Mathurinn/RoboRumble-Elimination-Submission/Folder C - Documentation/FQA_Proof/15 August.png

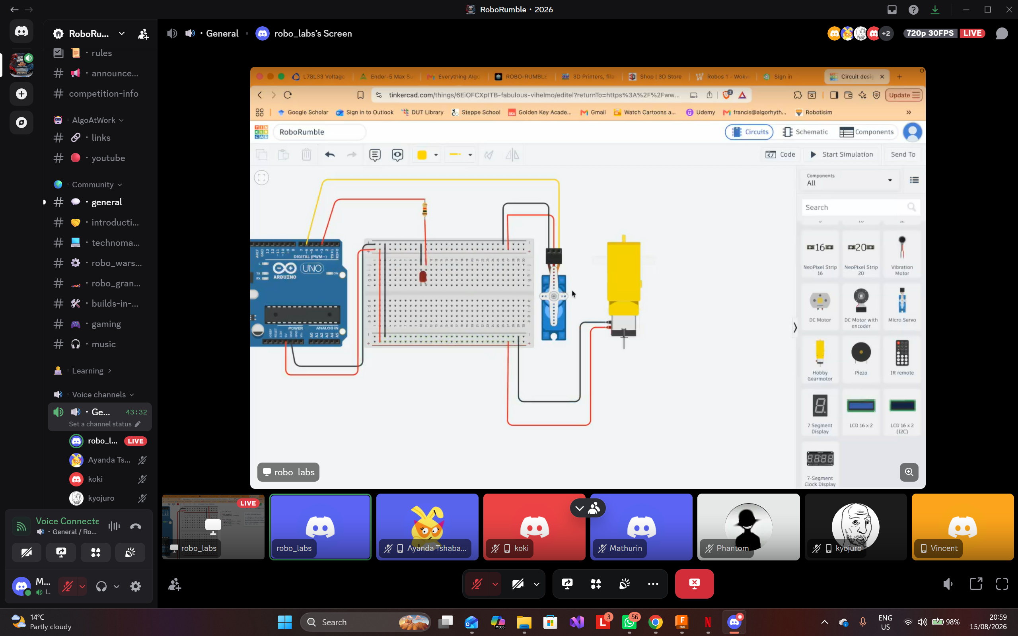
Folder C - Documentation/FQA_Proof/15 August.png
