Mathurinn/RoboRumble-Elimination-Submission/Folder A - Source Code/APEX_ONE_Flowchart.jpeg

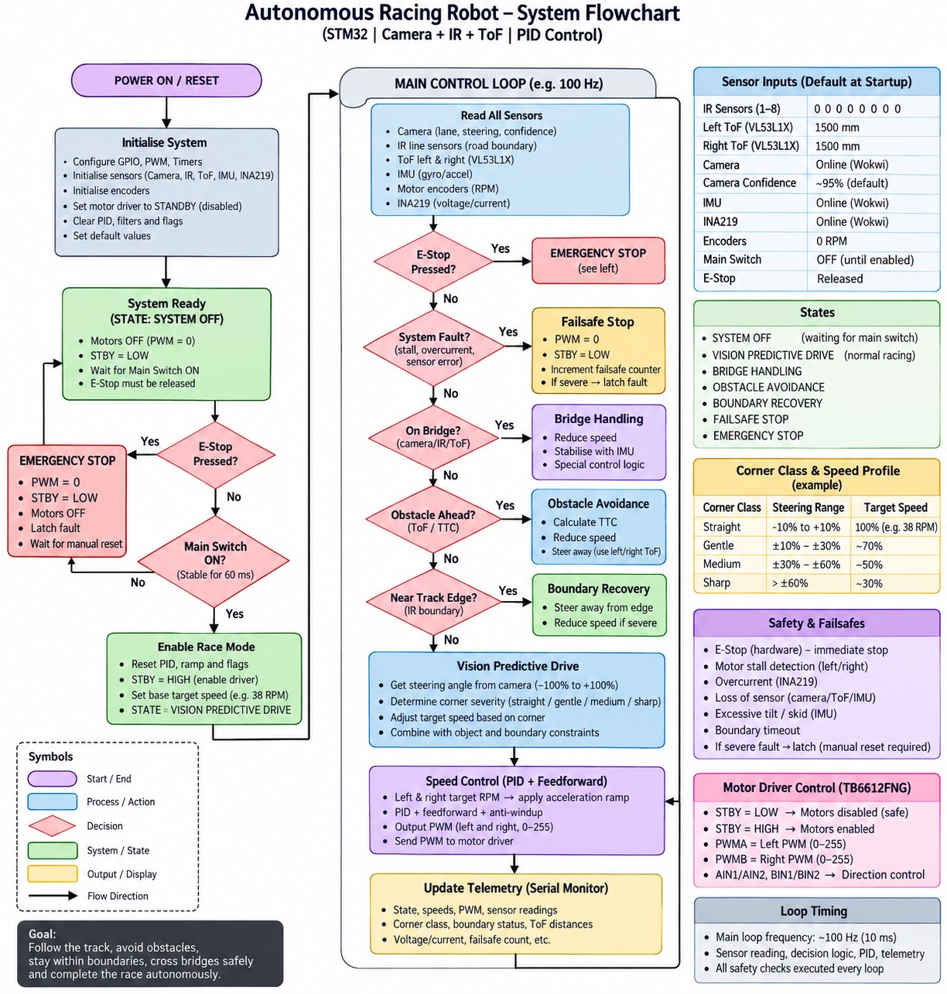
Folder A - Source Code/APEX_ONE_Flowchart.jpeg
