Mathurinn/RoboRumble-Elimination-Submission/Folder B - Designs/Mechanical_Design/APEX-ONE _ Mechanical Design.pdf

APEX-ONE / ROBO GRAND PRIX | MECHANICAL DESIGN

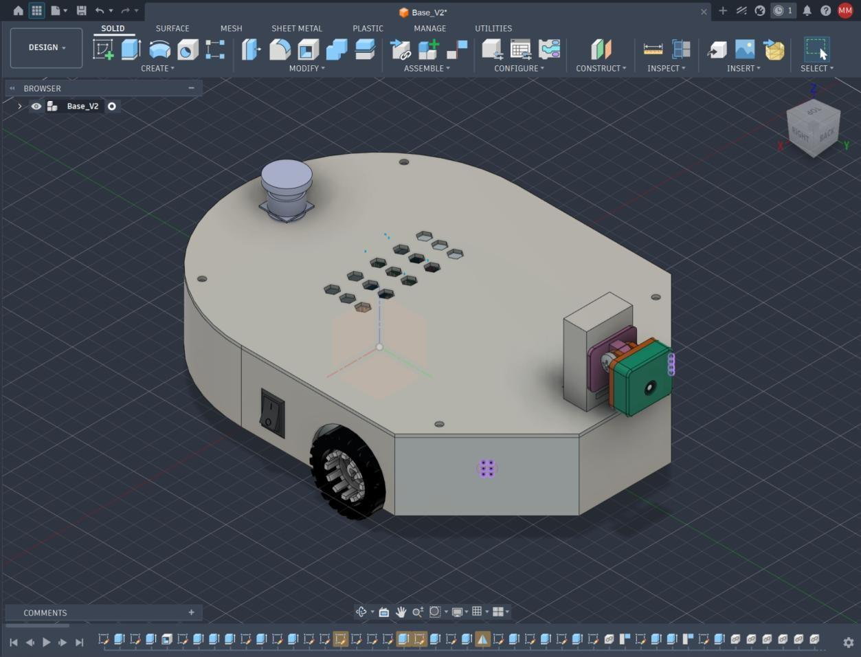
[picture p3: figure]

Mechanical Design | 1

MECHANICAL DESIGN

# Mechanical Design

- Raw CAD Assembly Files: The original 3D CAD file (APEX1.zip), compressed, is included in the repository's Mechanical Design folder for complete transparency regarding our mechanical architecture, dimensional tolerances, and 3D printing feasibility.

### Chassis Architecture & 3D Printing

The vehicle uses a custom-designed, two-piece chassis (base tub and top lid) which is fabricated using 3D printing. The shell is printed using a tri-hexagonal infill pattern which provides a better strength-to-weight density compared to standard grid infills. This helps balance structural integrity and economic feasibility. The chassis density is reduced to 15% to keep the chassis economically viable while maintaining a low chance of chipping. Localized areas supporting the hardware components are printed at a density of 20-25% to ensure that the threads and pillars are able to withstand mechanical stress and maintain a stable centre of gravity.

### Drive System and Kinematics

The robot makes use of a differential drive system that uses two GA12-N20 DC gear motors. These motors are fastened to the chassis using dedicated gear mounts and screws with locking nuts. Traction is provided by 43mm diameter wheels that fit directly onto the D-shafts of the gear motors. A rear-mounted castor ball wheel is secured directly through the underside of the chassis with locking nuts. This helps to establish a stable, 3-point turning radius that helps ground the weight of the chassis.

### Component Fastening and Electronic Integration

The internal electronics of the robot are designed for modularity and vibration resistance. The primary modules and microcontrollers, such as the STM32 Blue Pill, LM2596 buck converter, and motor driver, are not permanently soldered into the perfboard. They are placed into female header pins which are soldered onto the perfboard. The perfboard is screwed securely into structural pillars that are integrated into the chassis tub. The secondary processor, the Raspberry Pi, is screwed into four pillars on the underside of the lid to isolate it from motor vibration and to create more space inside the tub of the chassis. The Raspberry Pi Camera module is placed in an adjustable mount that is fused with the top lid of the chassis.

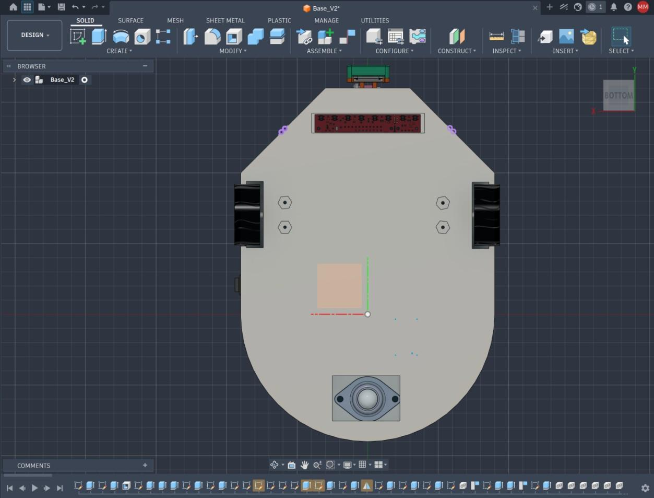
[picture p4: figure]

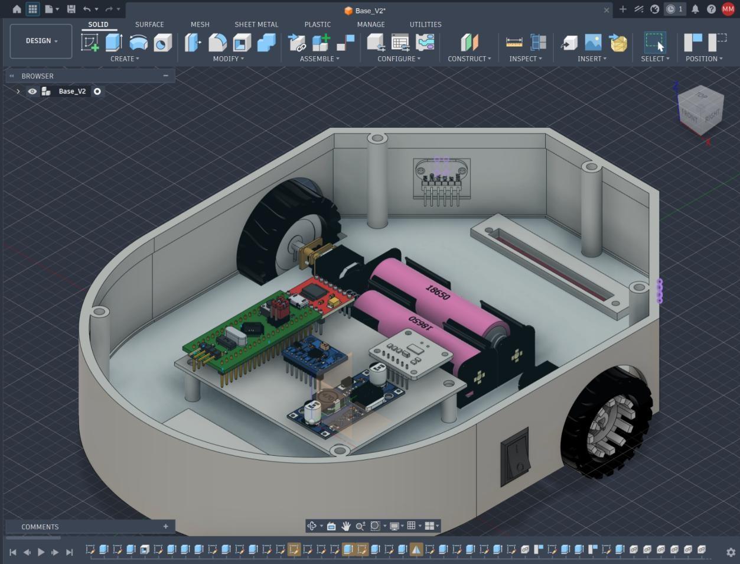
[picture p5: figure]

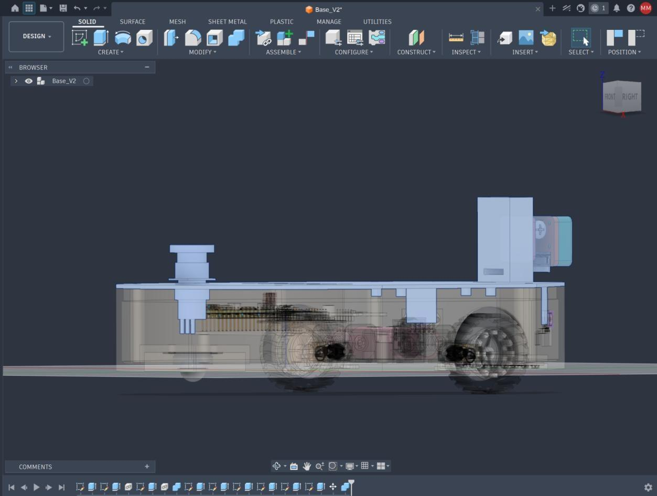
[picture p6: figure]

### Safety Mechanisms and Sensor Placement

The physical chassis incorporates dedicated housing for power cutoff systems in accordance with the competition's safety constraints. A primary rocker switch is fitted through a measured cutout in the side wall of the chassis, while the mandatory E-Stop (Emergency Stop) is mounted on the top of the lid for easier, immediate external access. For autonomous navigation, two ToF sensors are fitted into the front of the chassis at outward 45-degree angles to assist with cornering predictions. The top lid acts as a back support brace for these sensors, ensuring that they remain perfectly aligned in the case of high-speed collisions. The QTR-8RC is placed under the vehicle at a height that is optimal for operation and is bolted onto the inside of the chassis.

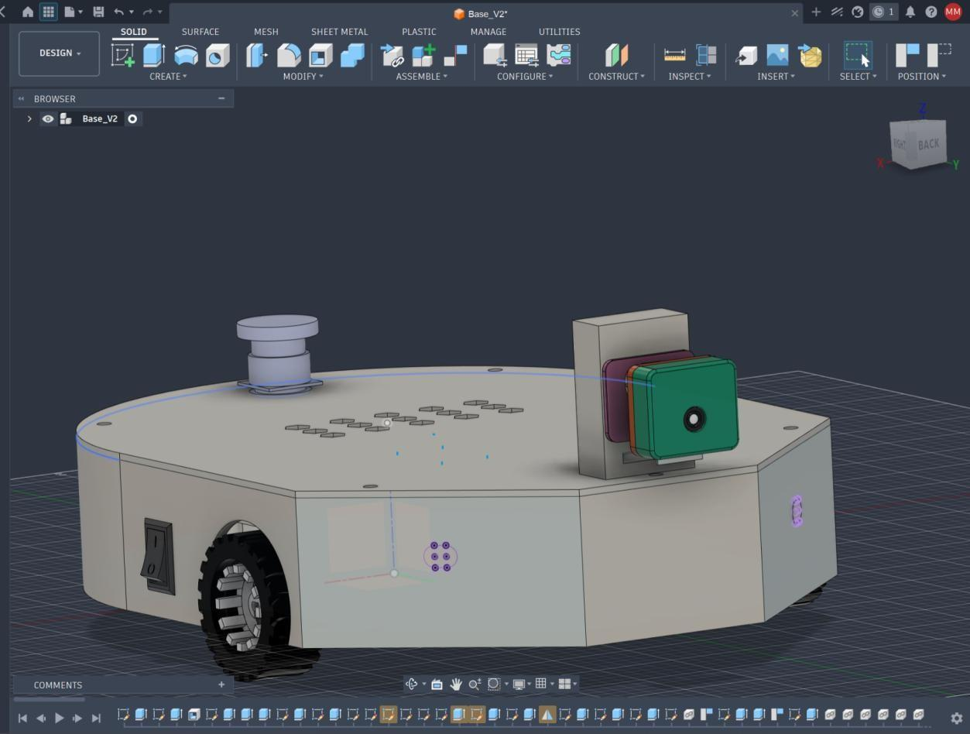
[picture p7: figure]

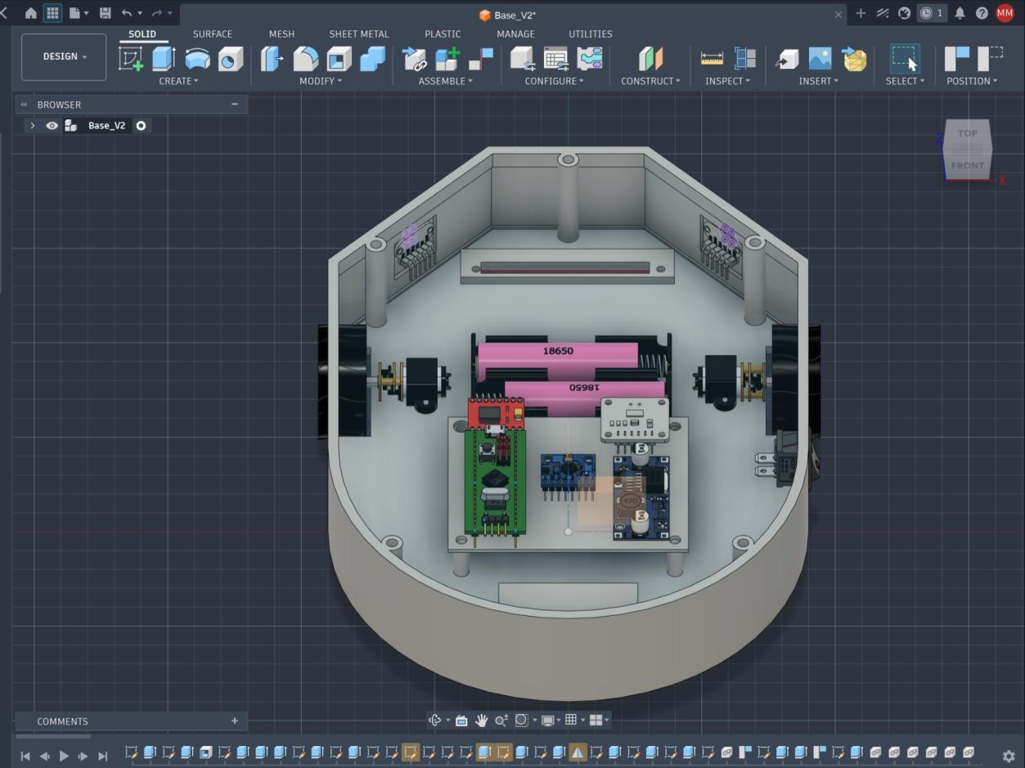
[picture p8: figure]

This formatting perfectly aligns with your electronic document. The physical placement of the E-Stop and rocker switch is explicitly detailed, hitting the safety requirements right on the head.
