Mathurinn/RoboRumble-Elimination-Submission/Folder C - Documentation/Apex_One_Pitch_Deck.pdf

ROBO RUMBLE · ROBO GRAND PRIX CATEGORY

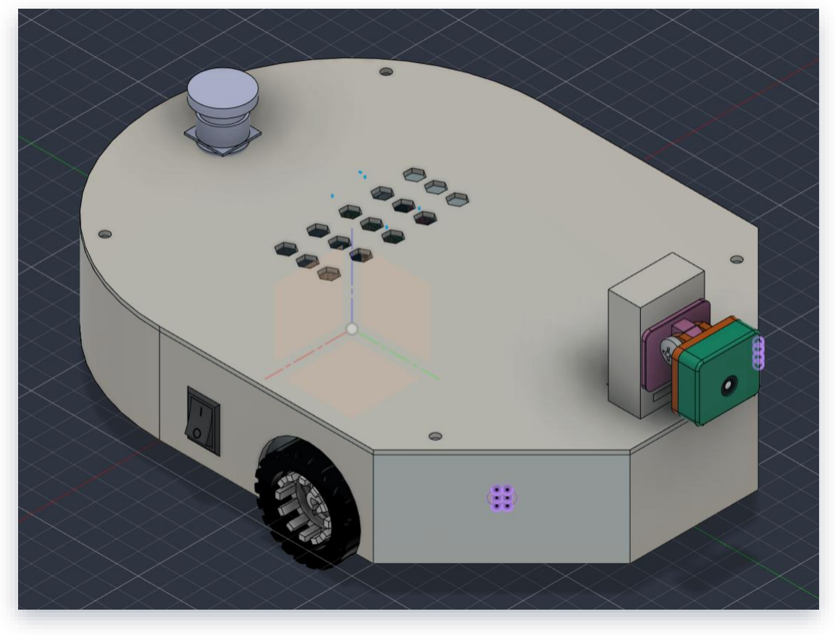
[picture p17: figure]

# APEX-ONE

# AUTONOMOUS RACING SYSTEM

### TEAM APEX

Tshwane University of Technology

### “Engineered for high-speed precision, local viability, and robust autonomous navigation.”

APEX-ONE · TEAM APEX · TSHWANE UNIVERSITY OF TECHNOLOGY

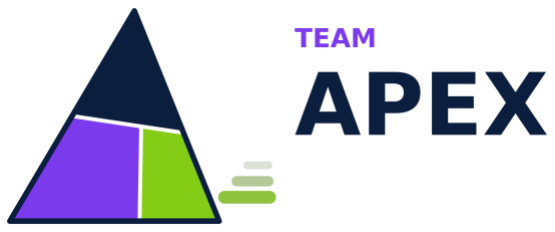
[picture p18: figure]

## THE CHALLENGE: SPEED VS. PROCESSING BOTTLENECKS

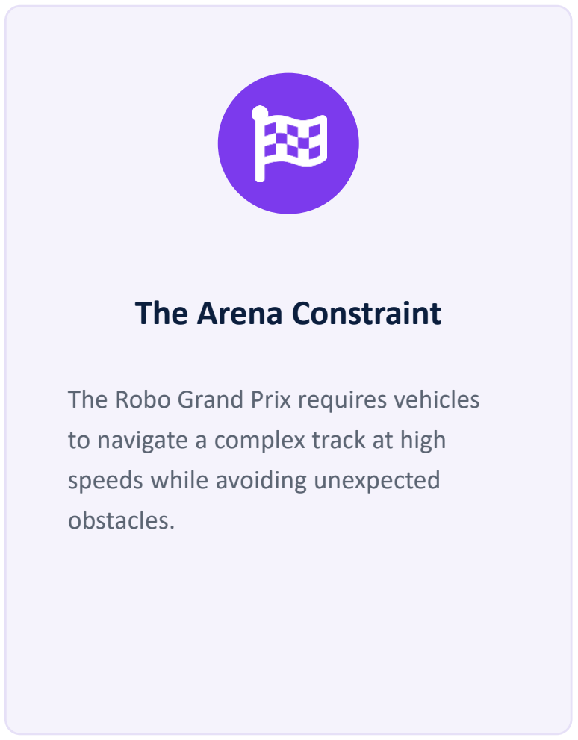
[picture p19: figure]
The Arena Constraint; The Robo Grand Prix requires vehicles to navigate a complex track at high; speeds while avoiding unexpected obstacles.
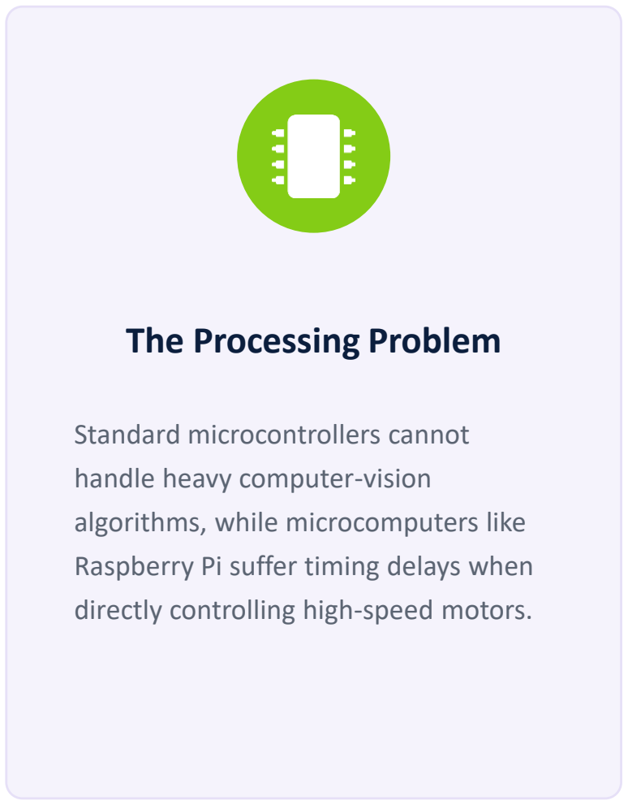
[picture p20: figure]
The Processing Problem; Standard microcontrollers cannot handle heavy computer-vision; algorithms, while microcomputers like Raspberry Pi suffer timing delays when; directly controlling high-speed motors.
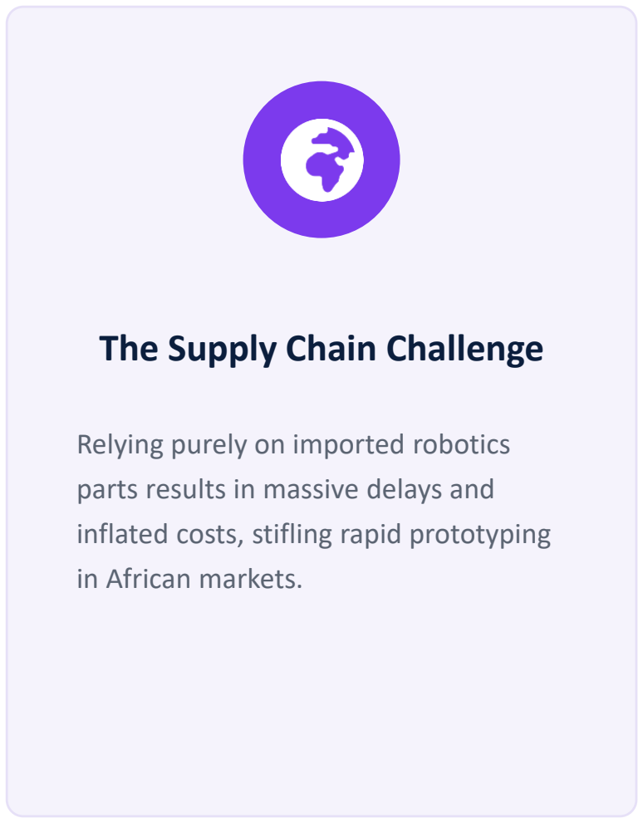
[picture p21: figure]
The Supply Chain Challenge; Relying purely on imported robotics parts results in massive delays and; inflated costs, stifling rapid prototyping in African markets.

APEX-ONE · TEAM APEX | 02 / 07

## THE APEX-ONE SOLUTION: DUAL-CORE ARCHITECTURE

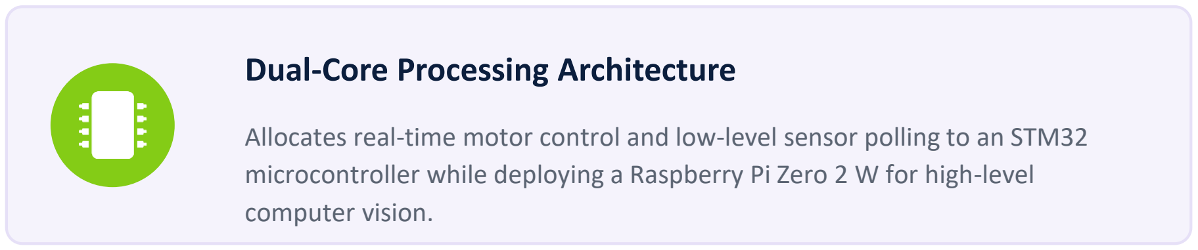
[picture p22: figure]
Dual-Core Processing Architecture; computer vision.

Allocates real-time motor control and low-level sensor polling to an STM32 microcontroller while deploying a Raspberry Pi Zero 2 W for high-level

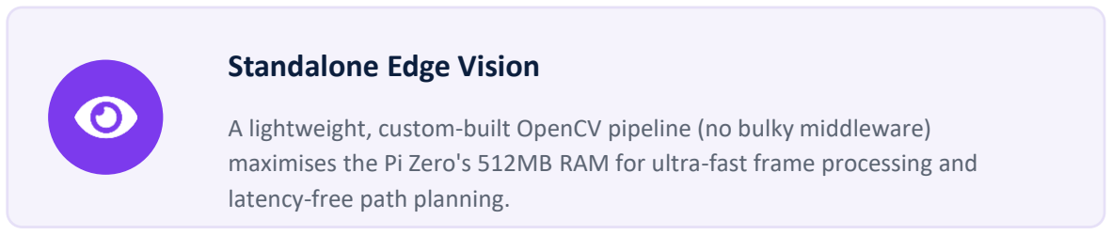
[picture p23: figure]
Standalone Edge Vision; latency-free path planning.

A lightweight, custom-built OpenCV pipeline (no bulky middleware) maximises the Pi Zero's 512MB RAM for ultra-fast frame processing and

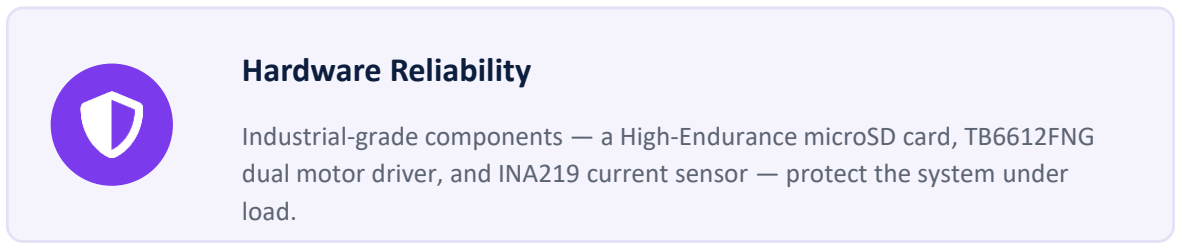
[picture p24: figure]
Hardware Reliability; load.

Industrial-grade components — a High-Endurance microSD card, TB6612FNG dual motor driver, and INA219 current sensor — protect the system under

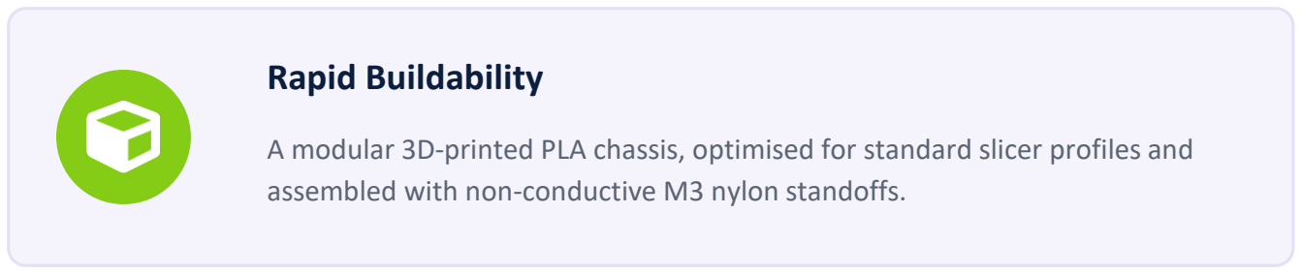
[picture p25: figure]
Rapid Buildability

A modular 3D-printed PLA chassis, optimised for standard slicer profiles and assembled with non-conductive M3 nylon standoffs.

S Y S T E M D A T A F L O W

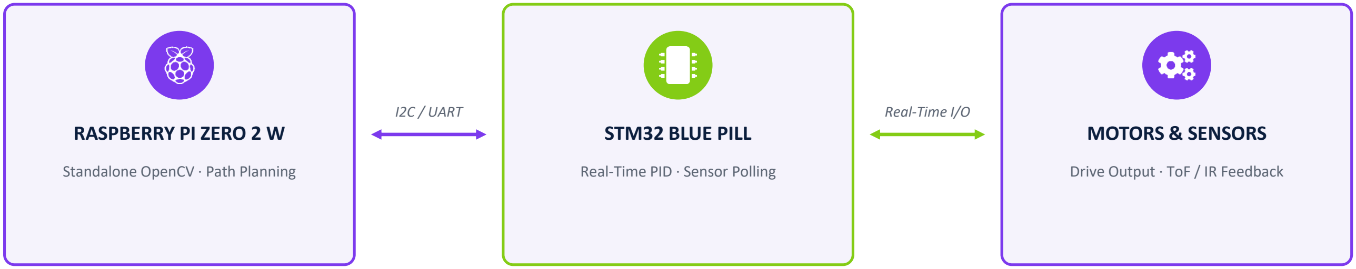
[picture p26: figure]
RASPBERRY PI ZERO 2 W; Standalone OpenCV · Path Planning; STM32 BLUE PILL; Real-Time PID · Sensor Polling; MOTORS & SENSORS; Drive Output · ToF / IR Feedback; I2C / UART; Real-Time I/O

# RAPID FABRICATION & STRATEGIC SOURCING

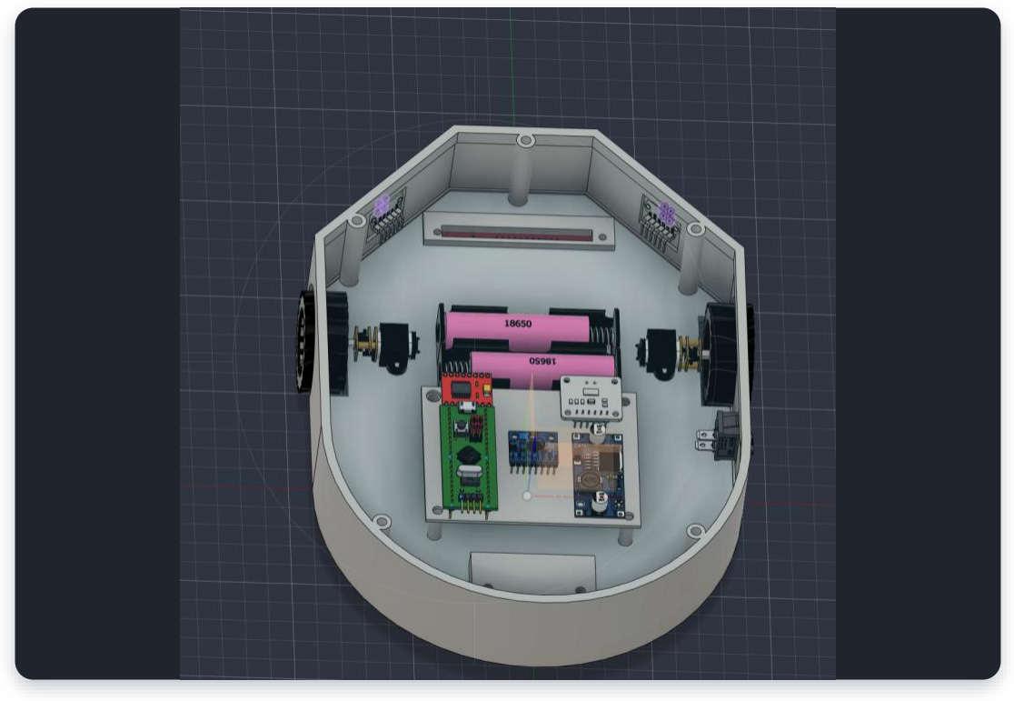
[picture p27: figure]

### Strategic Sourcing

95% of components — sensors, logic, power — are sourced locally (DIYElectronics, Communica, Bob Shop) for 2-day delivery. Only the specialised, high-RPM N20 gear motors were imported via AliExpress to optimise the speed-to-cost ratio.

### Modular Mechanical Design

The chassis tub and lid are 100% 3D-printed in standard PLA (~250g).

### Scalable Assembly

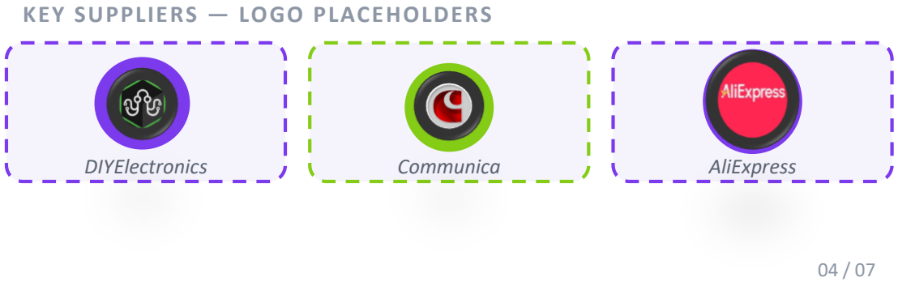
[picture p28: figure]
KEY SUPPLIERS — LOGO PLACEHOLDERS; DIYElectronics; Communica; AliExpress

Elevated perfboard mounting using non-conductive M3 nylon standoffs ensures a clean, easily repairable electrical deck for trackside maintenance.

## FINANCIAL DOCUMENTATION (BILL OF MATERIALS)

T O T A L I M P L E M E N T A T I O N C O S T
R 3,545.39

(Includes Local VAT; Excludes Shipping)

Verdict: A highly competitive price-to-performance ratio achieved by avoiding expensive pre-built robotic platforms in favor of custom integration.

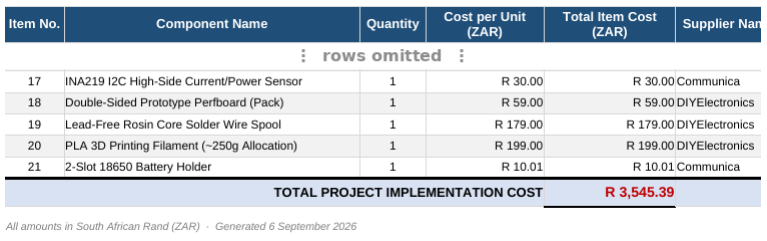
[picture p29: figure]

Official Bill of Materials — final total highlighted in red

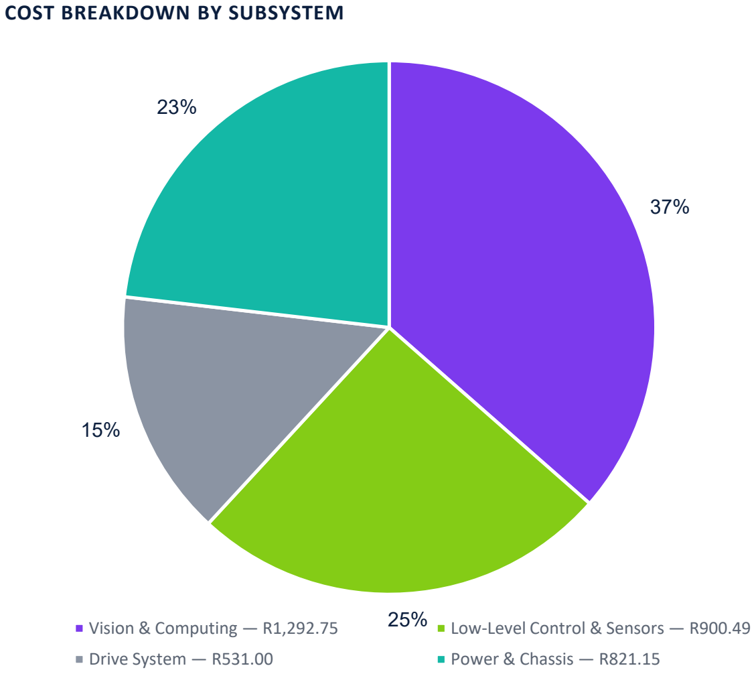
[picture p30: figure]
COST BREAKDOWN BY SUBSYSTEM; Drive System — R531.00; Power & Chassis — R821.15

Vision & Computing — R1,292.75 | Low-Level Control & Sensors — R900.49

# MANDATORY SAFETY & ELECTRICAL RIGOR

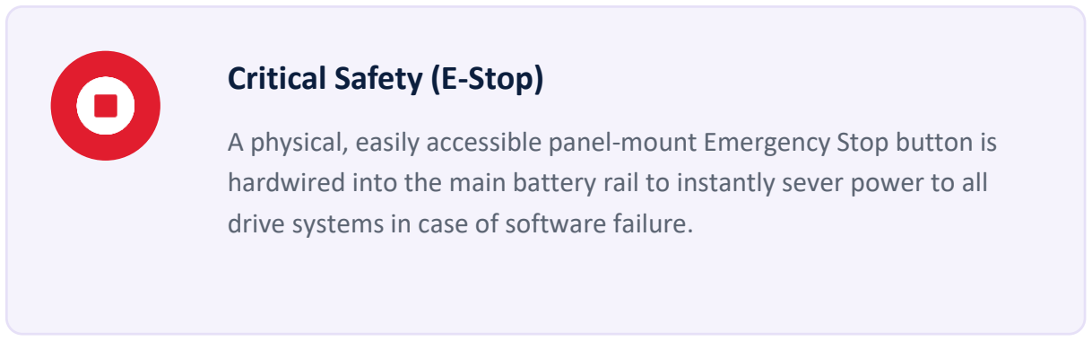
[picture p31: figure]
Critical Safety (E-Stop)

A physical, easily accessible panel-mount Emergency Stop button is hardwired into the main battery rail to instantly sever power to all drive systems in case of software failure.

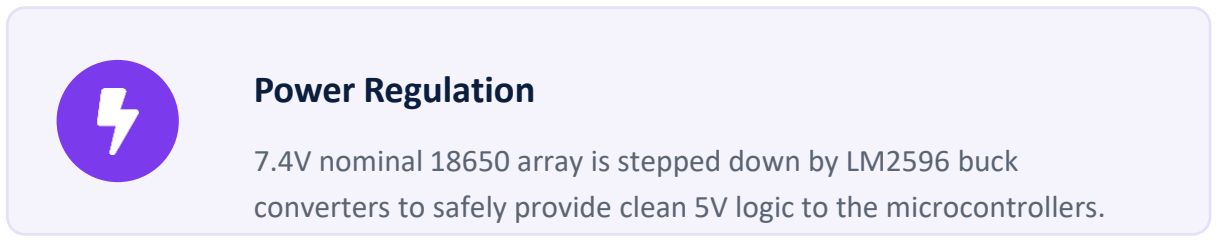
[picture p32: figure]
Power Regulation
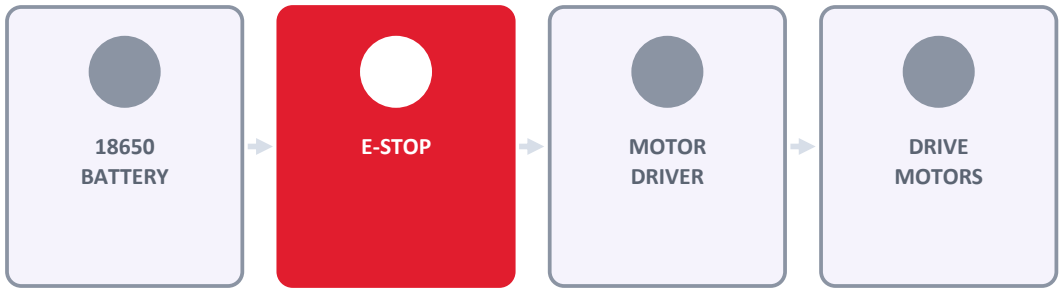
[picture p33: figure]
18650 BATTERY; E-STOP; MOTOR; DRIVER; DRIVE MOTORS

7.4V nominal 18650 array is stepped down by LM2596 buck converters to safely provide clean 5V logic to the microcontrollers.

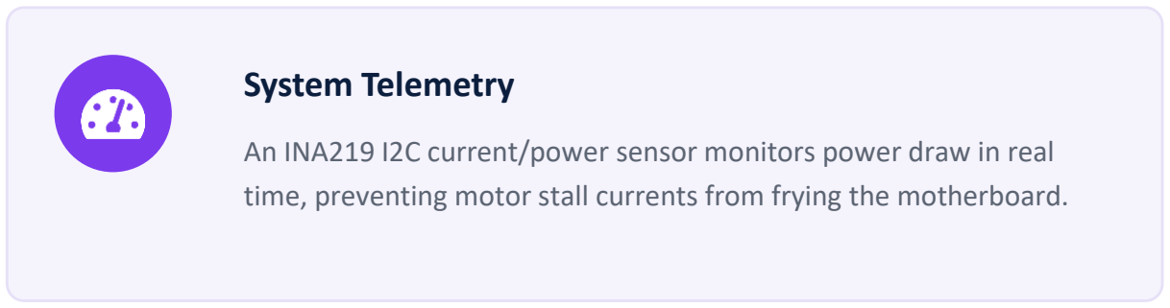
[picture p34: figure]
System Telemetry

An INA219 I2C current/power sensor monitors power draw in real time, preventing motor stall currents from frying the motherboard.

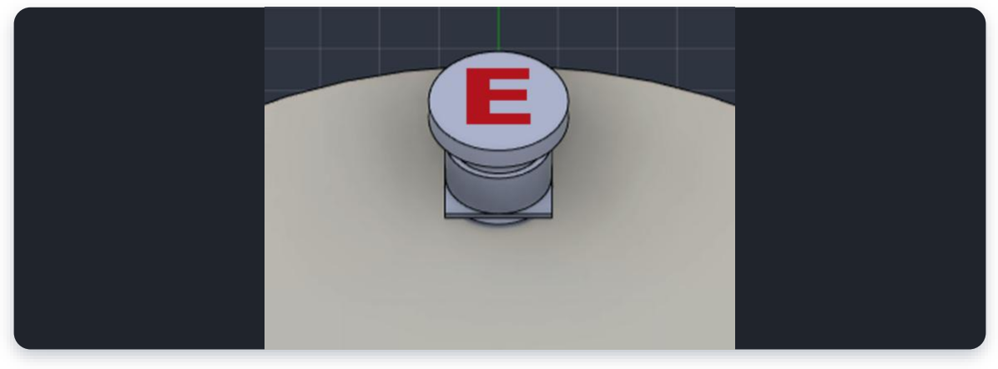
[picture p35: figure]

S A F E T Y C U T O F F P A T H

# TEAM APEX

The People Behind Apex-One

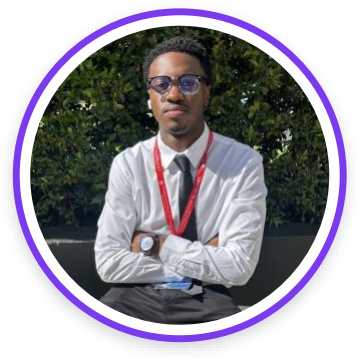
[picture p36: figure]

## Mathurin Nimrod Moundzika-Kibamba

Project Lead / Hardware

- Mechanical CAD design, electronic circuit layout, power distribution, and BOM validation.
- Simulation designer and project overseer

Co-lead on physical fabrication and hardware assembly.

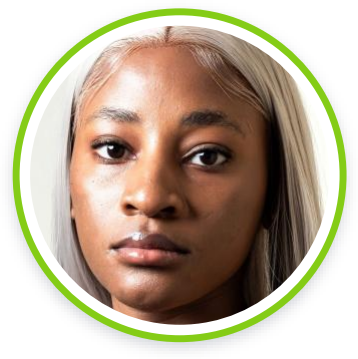
[picture p37: figure]

## Ayanda Delight Tshabangu

Project Lead / Software

- Embedded firmware and low-level hardware driver development (C++/STM32).
- High-level standalone OpenCV computer-vision pipeline and path-planning algorithms.

Co-lead on physical fabrication and hardware assembly.
