Mathurinn/RoboRumble-Elimination-Submission/Folder C - Documentation/FQA_Attendance_Log.md

# Robo Rumble: Facilitator Q&A (FQ&A) Attendance Logbook

**Team Name:** Team Apex (Mathurin Moundzika-Kibamba & Ayanda Tshabangu)
**Category:** Robo Grand Prix

*Instructions: To qualify for the 10 Bonus Points, log your attendance for every FQ&A session below. You must include a direct link to a screenshot proving your attendance (e.g., a screenshot of the meeting lobby or chat with your username visible).*

## Attendance Log

| Session Date | Time (Start-End) | Facilitator Name/Username | Our Key Takeaway / Question Asked | Proof of Attendance (Screenshot) |
| :--- | :--- | :--- | :--- | :--- |
| 2026-08-05 | 18:10 - 19:30 | robo_labs | Initial introductory session covering competition scope and general hardware limitations. | [Link to image in repo](./FQA_Proof/5%20August.png) |
| 2026-08-12 | 14:00 - 14:30 | OM_Kupa@1 | Track focus. Discussed not making the design based on a specific track idea. | [Link to image in repo](./FQA_Proof/12%20August%20(1).png) |
| 2026-08-14 | 21:00 - 21:30 | robo_labs | Basics of microcontroller programming was learnt. | [Link to image in repo](./FQA_Proof/14%20August.png) |
| 2026-08-15 | 20:15 - 21:15 | robo_labs | Microcontroller programming.  Always credit your sources. Project resources for learning were shared. | [Link to image in repo](./FQA_Proof/15%20August.png) |
| 2026-09-03 | 20:30 - 21:30 | robo_labs | Final sprint technical Q&A. Reviewed final submission requirements and clarified GitHub repository structure parameters. Final tips about the design were given with regards to 3D printing and electrical components being used for the robot | [Link to image in repo](./FQA_Proof/3%20September.png) |

***

### Screenshot Directory
*Please ensure all screenshots referenced above are saved in a folder named `FQA_Proof` within your Documentation Folder.*
