Mathurinn/RoboRumble-Elimination-Submission/Folder B - Designs/Schematics/Proteus_Screenshot.png

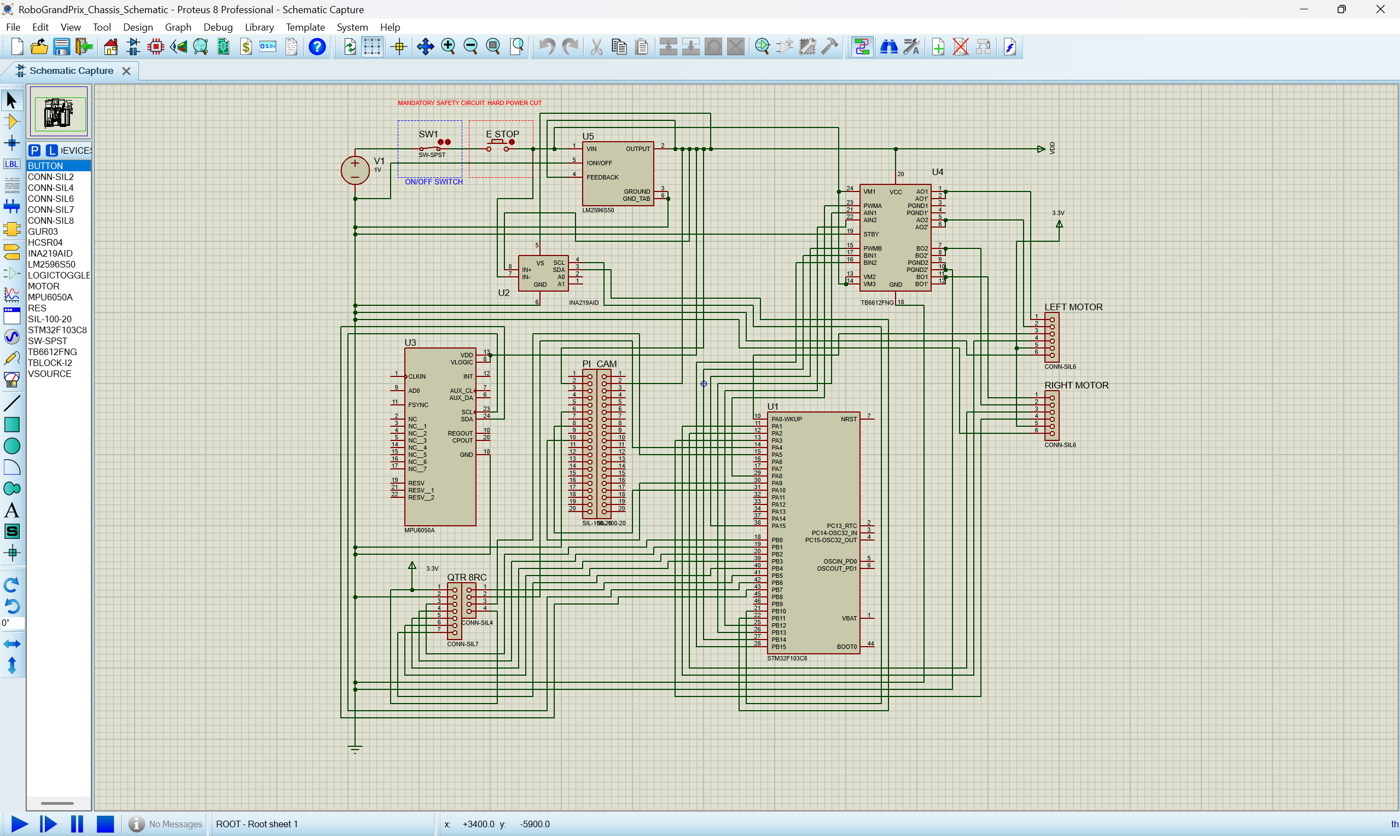
Folder B - Designs/Schematics/Proteus_Screenshot.png
