Mathurinn/RoboRumble-Elimination-Submission/Folder B - Designs/Schematics/Wokwi_Screenshot.png

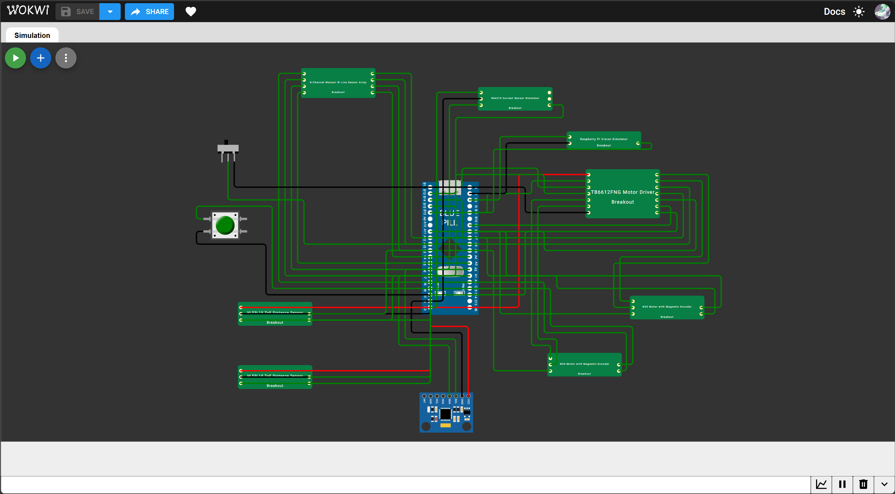
Folder B - Designs/Schematics/Wokwi_Screenshot.png
