Mathurinn/RoboRumble-Elimination-Submission/Folder C - Documentation/FQA_Proof/3 September.png

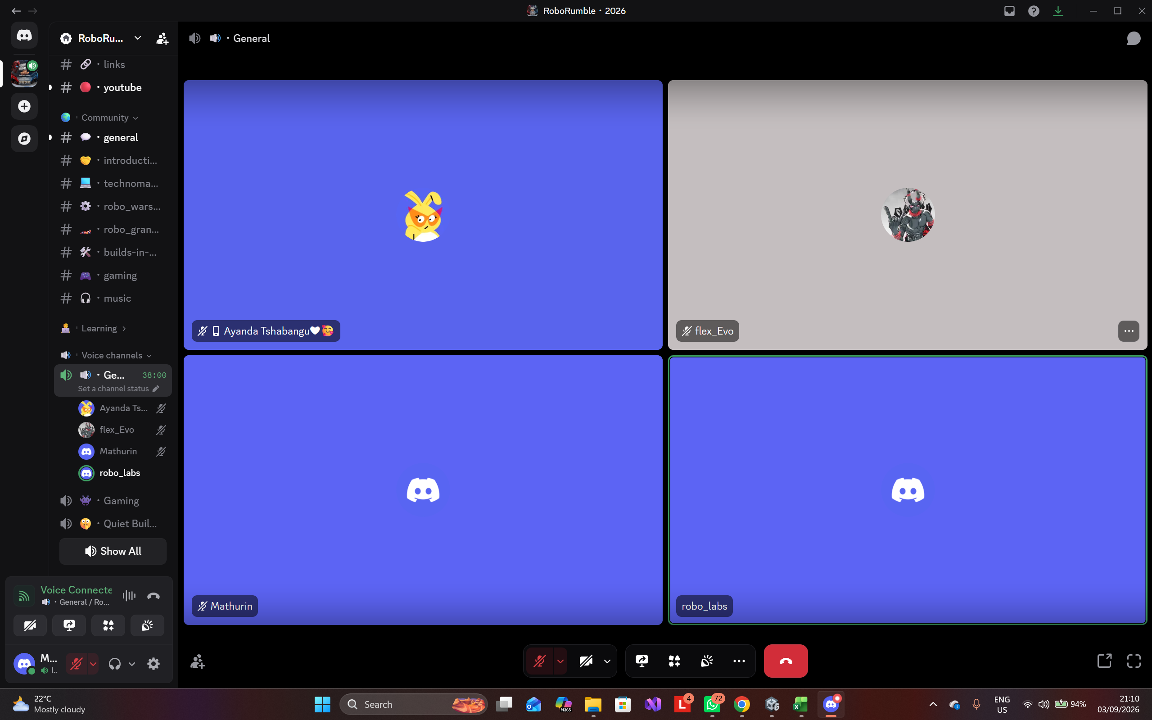
Folder C - Documentation/FQA_Proof/3 September.png
