Mathurinn/RoboRumble-Elimination-Submission/Folder C - Documentation/FQA_Proof/5 August.png

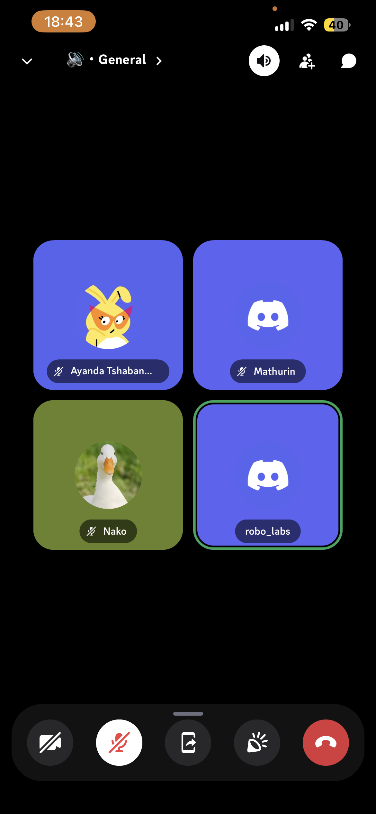
Folder C - Documentation/FQA_Proof/5 August.png
