Mathurinn/RoboRumble-Elimination-Submission/Folder C - Documentation/FQA_Proof/12 August (1).png

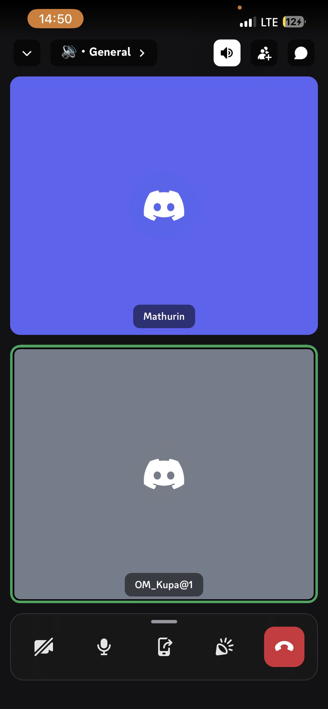
Folder C - Documentation/FQA_Proof/12 August (1).png
