Mathurinn/RoboRumble-Elimination-Submission/Folder C - Documentation/FQA_Proof/14 August.png

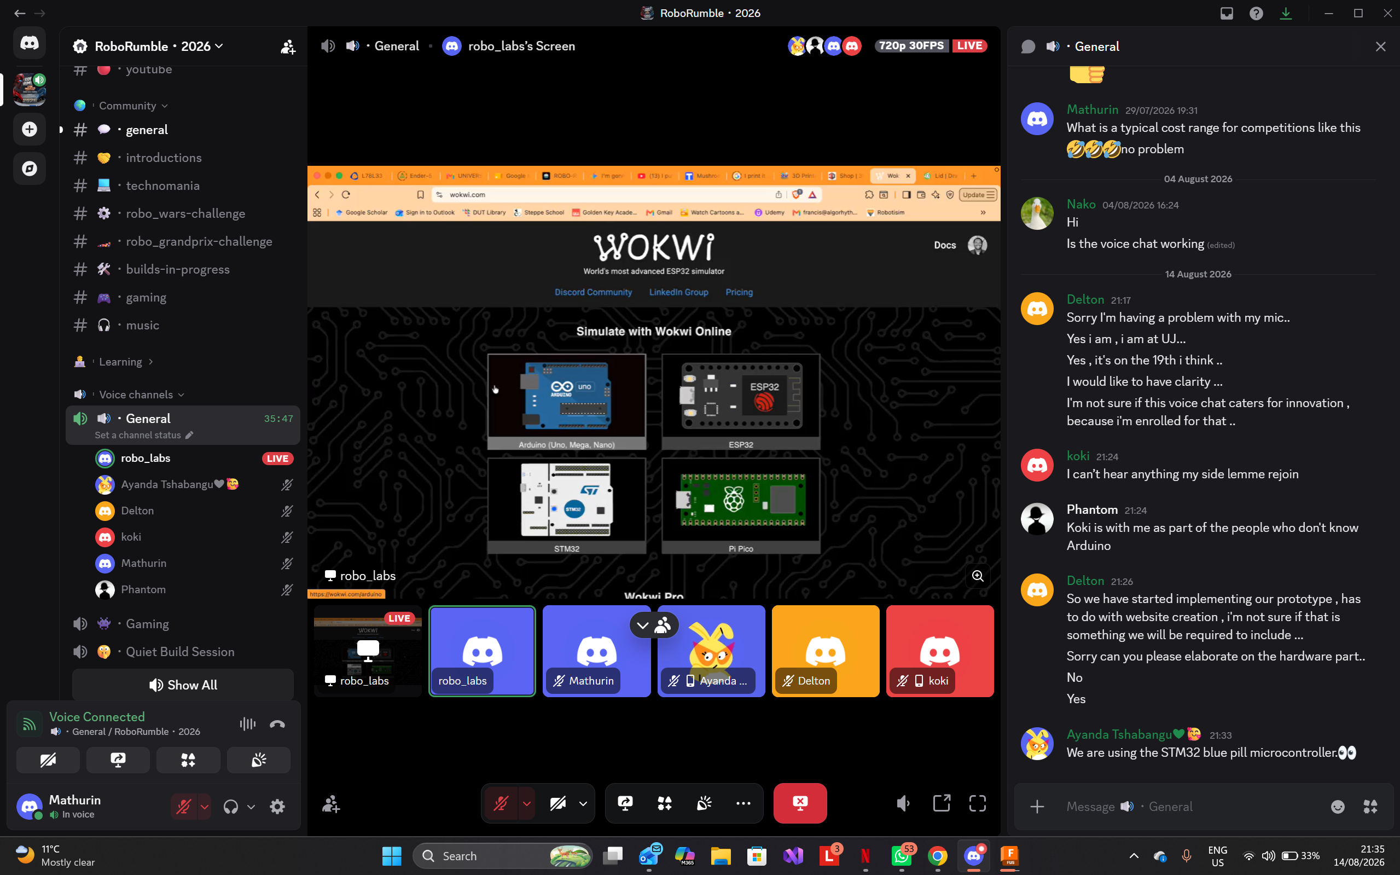
Folder C - Documentation/FQA_Proof/14 August.png
