Mathurinn/RoboRumble-Elimination-Submission/Folder C - Documentation/Bill_of_Materials.xlsx

Bill of Materials
Component & Supplier Cost Breakdown
Item No. | Component Name | Quantity | Cost per Unit (ZAR) | Total Item Cost (ZAR) | Supplier Name | Supplier Stock Code | Direct Purchase URL
1 | STM32F103C8T6 (Blue Pill MCU) | 1 | R 47.99 | R 47.99 | Communica | BMT STM32F103C8T6 MINI DEV BOARD | View Product (https://tinyurl.com/25pbtawa)
2 | ST-Link V2 USB Programmer | 1 | R 55.00 | R 55.00 | Communica | HKD ST-LINK PROGRAMME V2 STM8/32 | View Product (https://tinyurl.com/ysv4c6z3)
3 | TB6612FNG Dual Motor Driver Module | 1 | R 116.00 | R 116.00 | DIYElectronics | 9MDTB6612FB | View Product (https://tinyurl.com/2mvbed2k)
4 | N20 Micro Gear Motor + Encoder (6V 1500 RPM) | 2 | R 185.00 | R 370.00 | AliExpress | MOT-N20-ENC-1500 | View Product (https://www.aliexpress.com/i/1005004110888400.html)
5 | Metal Ball Caster Wheel (Front Support) | 1 | R 14.00 | R 14.00 | DIYElectronics | 9WROBOTBULL | View Product (https://tinyurl.com/2tr2hu6m)
6 | LM2596 Step-Down DC-DC Buck Converter | 1 | R 35.00 | R 35.00 | Communica | BMT ADJ DC/DC MODULE 3A 1,5-35V | View Product (https://tinyurl.com/yz44kttt)
7 | 18650 Li-ion Cells (3000mAh) | 1 | R 100.00 | R 100.00 | Communica | EJC18650 3000MAH 3.7V BATT SET | View Product (https://tinyurl.com/ybu84bhc)
8 | MPU6050 6-DOF IMU (Accelerometer / Gyro) | 1 | R 65.00 | R 65.00 | Make Electronics | 0ME1575 | View Product (https://tinyurl.com/3esbnrhr)
9 | Emergency Stop Switch & Power Toggle | 1 | R 88.00 | R 88.00 | DIYElectronics | 9SWPEP3PINSML | View Product (https://tinyurl.com/y7vshr2z)
10 | Female Header Pins | 4 | R 11.00 | R 44.00 | DIYElectronics | 9CONSIL15PSF | View Product (https://tinyurl.com/2s38wut6)
11 | M3 Standoffs Screws & Fasteners Kit | 2 | R 49.00 | R 98.00 | DIYElectronics | HWNYLONSO10 | View Product (https://tinyurl.com/ym4twhbt)
12 | 8-Channel High-Speed IR Array (QTR-8RC) | 1 | R 136.50 | R 136.50 | Bob Shop | C10-T13 | View Product (https://tinyurl.com/3etb3d6b)
13 | Raspberry Pi Zero 2 W (Vision Co-Processor) | 1 | R 436.00 | R 436.00 | DIYElectronics | 9RASPBZERO2W | View Product (https://tinyurl.com/md4axdpz)
14 | Raspberry Pi Camera Module 3 (Wide-Angle) | 1 | R 856.75 | R 856.75 | Communica | RASPBERRY PI CAM MODULE 3W ORIG | View Product (https://tinyurl.com/y7xb3tp7)
15 | High-Endurance 32GB MicroSD Card (U3/V30) | 1 | R 226.14 | R 226.14 | Bob Shop | SDSQQNR-032G-GN6IA | View Product (https://tinyurl.com/2zpz59uv)
16 | VL53L1X Time-of-Flight Distance Sensor (50Hz) | 2 | R 190.00 | R 380.00 | Communica | HKD VL53L1X LASER TOF SENS 400CM | View Product (https://www.communica.co.za/products/hkd-vl53l1x-laser-tof-sens-400cm)
17 | INA219 I2C High-Side Current/Power Sensor | 1 | R 30.00 | R 30.00 | Communica | BDD INA219 DC CURRENT SENSOR | View Product (https://tinyurl.com/bdkthxfw)
18 | Double-Sided Prototype Perfboard (Pack) | 1 | R 59.00 | R 59.00 | DIYElectronics | 9PCBPRODS100 | View Product (https://tinyurl.com/3xdyua26)
19 | Lead-Free Rosin Core Solder Wire Spool | 1 | R 179.00 | R 179.00 | DIYElectronics | SQSO.71MM125GR | View Product (https://tinyurl.com/2rtzujtk)
20 | PLA 3D Printing Filament (~250g Allocation) | 1 | R 199.00 | R 199.00 | DIYElectronics | HWPPPLAB1.75BK | View Product (https://tinyurl.com/4e8spyfp)
21 | 2-Slot 18650 Battery Holder | 1 | R 10.01 | R 10.01 | Communica | HKD LC18650X2 BATT HOLDER | View Product (https://tinyurl.com/56za3xfy)
TOTAL PROJECT IMPLEMENTATION COST |  |  |  | R 3545.39
All amounts in South African Rand (ZAR) · Generated 6 September 2026
