Mathurinn/RoboRumble-Elimination-Submission/(list of files, drawings)

Other design files:
Folder B - Designs/Schematics/RoboGrandPrix_Chassis_Schematic.pdsprj
