Mathurinn/RoboRumble-Elimination-Submission/(commit log)

2026-09-05 Enhance README with mechanical design details
    Added detailed sections on chassis architecture, drive system, component fastening, and safety mechanisms for the mechanical design of the robot.
2026-09-05 Add README.md for simulation testing and findings
    Documented simulation testing results and sensor limitations, including kinematic validation and state-machine validation.
2026-09-08 Add Mechanical Assembly documentation
2026-09-08 Fix links to Proteus Schematic and Wokwi Logic Map
    Updated schematic and logic map links to new directory structure.
